yashbakka/bcg-sleep-sensor/hardware/schematic-printable/BCG_Schematic.pdf

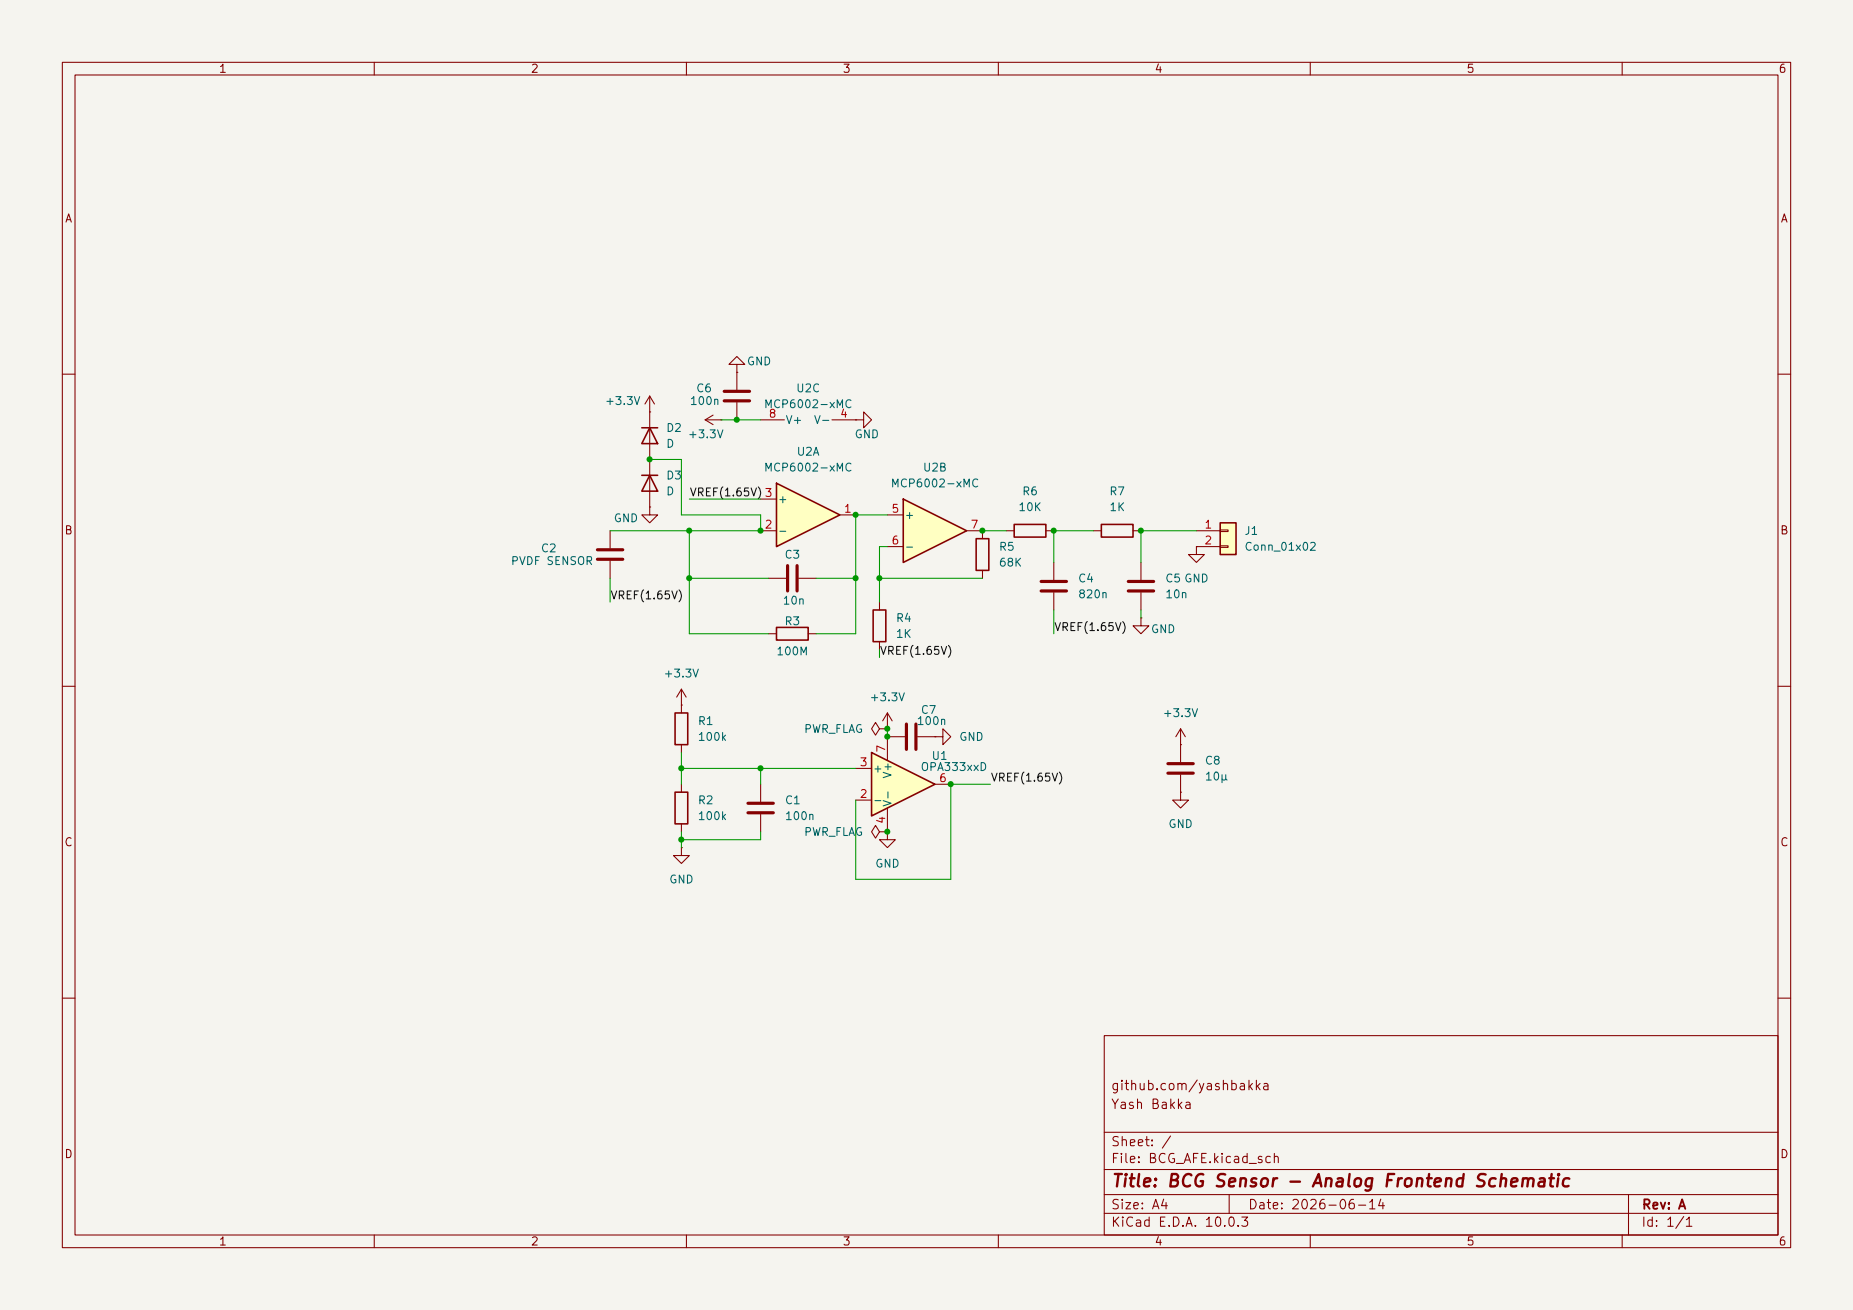
[picture p1: page 1]
