yashbakka/bcg-sleep-sensor/hardware/kicad/BCG_Sensor_SchematicV1.kicad_sch

## KiCad design hardware/kicad/BCG_Sensor_SchematicV1.kicad_sch (2026-10-16)

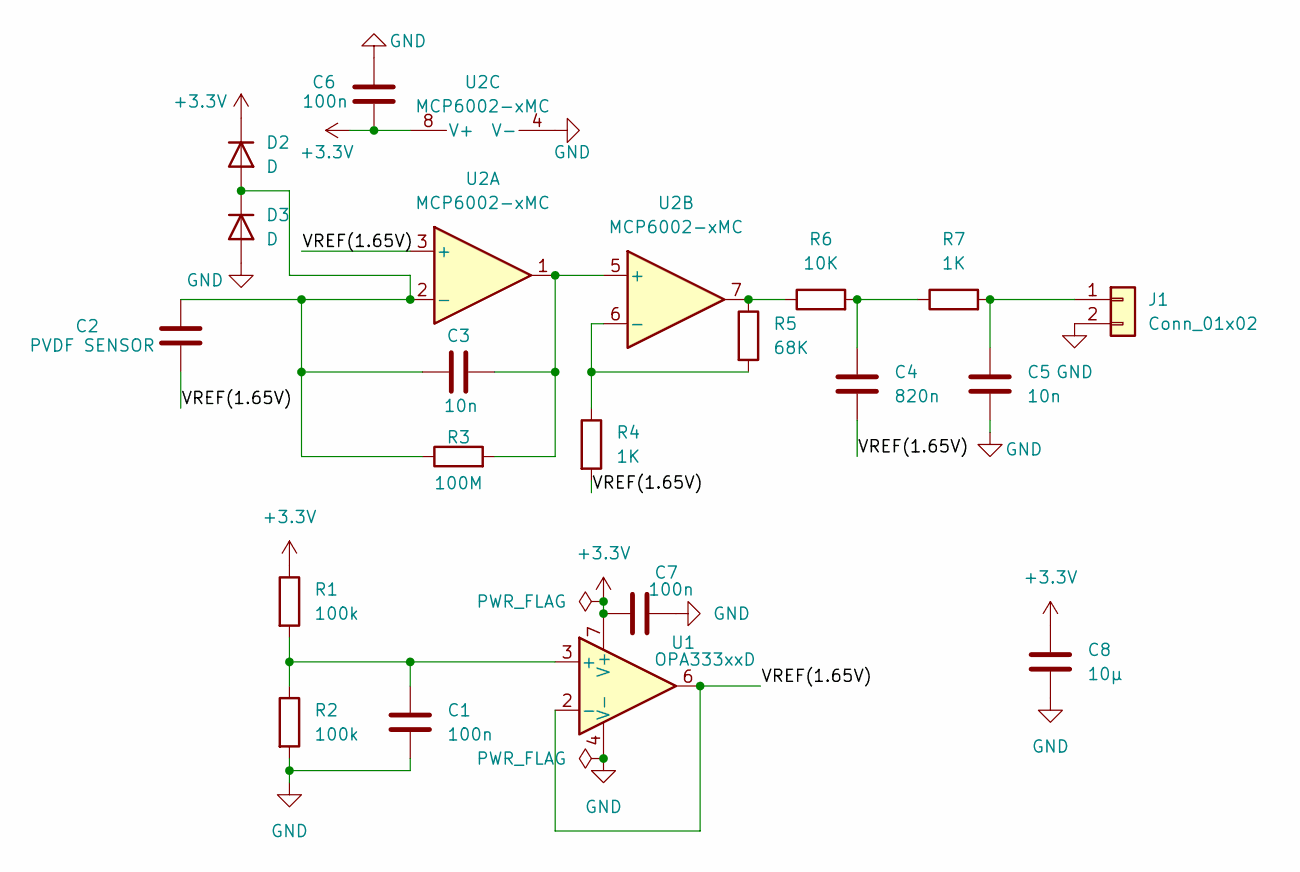
[picture p2: schematic BCG_Sensor_SchematicV1.kicad_sch]

Parts:
C1, C6, C7: 100n
C2: PVDF SENSOR
C3, C5: 10n
C4: 820n
C8: 10µ
D2, D3: D
J1: Conn_01x02
R1, R2: 100k
R3: 100M
R4, R7: 1K
R5: 68K
R6: 10K
U1: OPA333xxD; SOIC-8_3.9x4.9mm_P1.27mm
U2: MCP6002-xMC; DFN-8-1EP_3x2mm_P0.5mm_EP1.75x1.45mm

Connections:
+3.3V: C6.2, C7.1, C8.1, D2.1 (K), R1.1, U1.7 (V+), U2.8 (V+)
GND: C1.1, C5.2, C6.1, C7.2, C8.2, D3.2 (A), J1.2, R2.2, U1.4 (V-), U2.4 (V-), U2.9 (V-)
unnamed: C1.2, R1.2, R2.1, U1.3 (+)
unnamed: C2.1, C3.1, D2.2 (A), D3.1 (K), R3.1, U2.2 (-)
unnamed: C3.2, R3.2, U2.1, U2.5 (+)
unnamed: C4.1, R6.2, R7.1
unnamed: C5.1, J1.1, R7.2
unnamed: R4.1, R5.2, U2.6 (-)
unnamed: R5.1, R6.1, U2.7
VREF(1.65V): C2.2, C4.2, R4.2, U1.2 (-), U1.6, U2.3 (+)
